Aiita/TP-Solarius/README.md

TP-Solarius - Lire explication projet pour plus d'information

Sommaire:
- Dossier à disposition: 
    - Programmes Solarius:
      - Programme de la mesure de puissance
      - Programme pour le fonctionnement du data logger
      - Mélange programme de mesure de la puissance et du fonctionnement du data logger
      - Programme lié au scénario 1
      - Programme lié au scénario 2

    - Documents Solarius
      - Flowchart scénario 1 et scénario 2 (format .png)
      - PV de livraison du produit
      
    - Vidéos/Photos 
      - Vidéo du fonctionnement du suivi de la lumière
      - Photo du montage fini du robot avec ses branchement
      - Vidéo du fonctionnement de la mesure de tension et de la puissance
      - Photo du fichier CSV après fonctionnement
