Aiita/TP-Solarius/Document_Solarius/Flowchart scénario 1.png

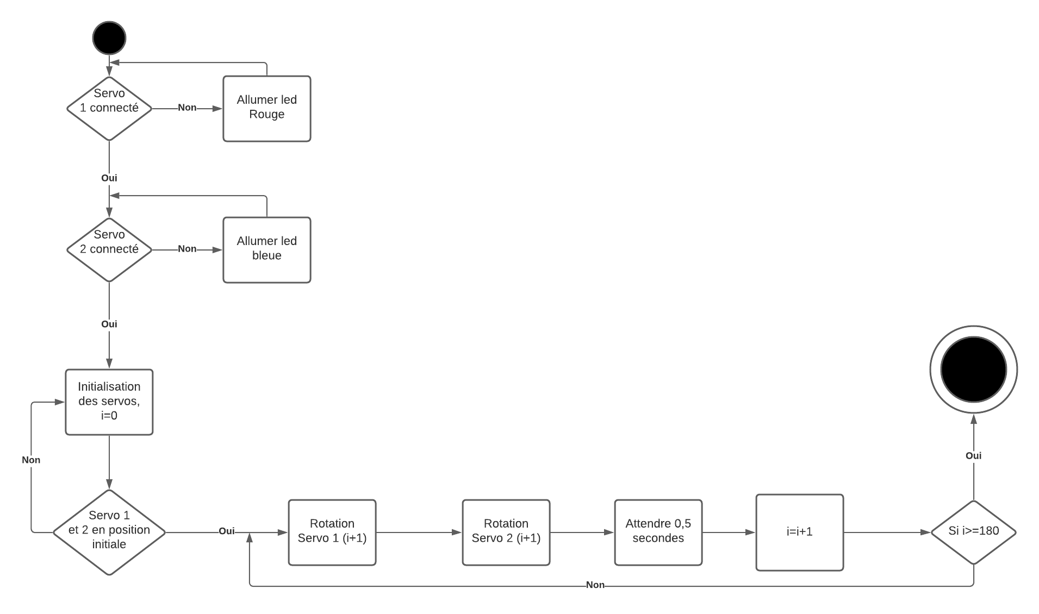
Document_Solarius/Flowchart scénario 1.png
