Aiita/TP-Solarius/Document_Solarius/Flowchart scénario 2.PNG

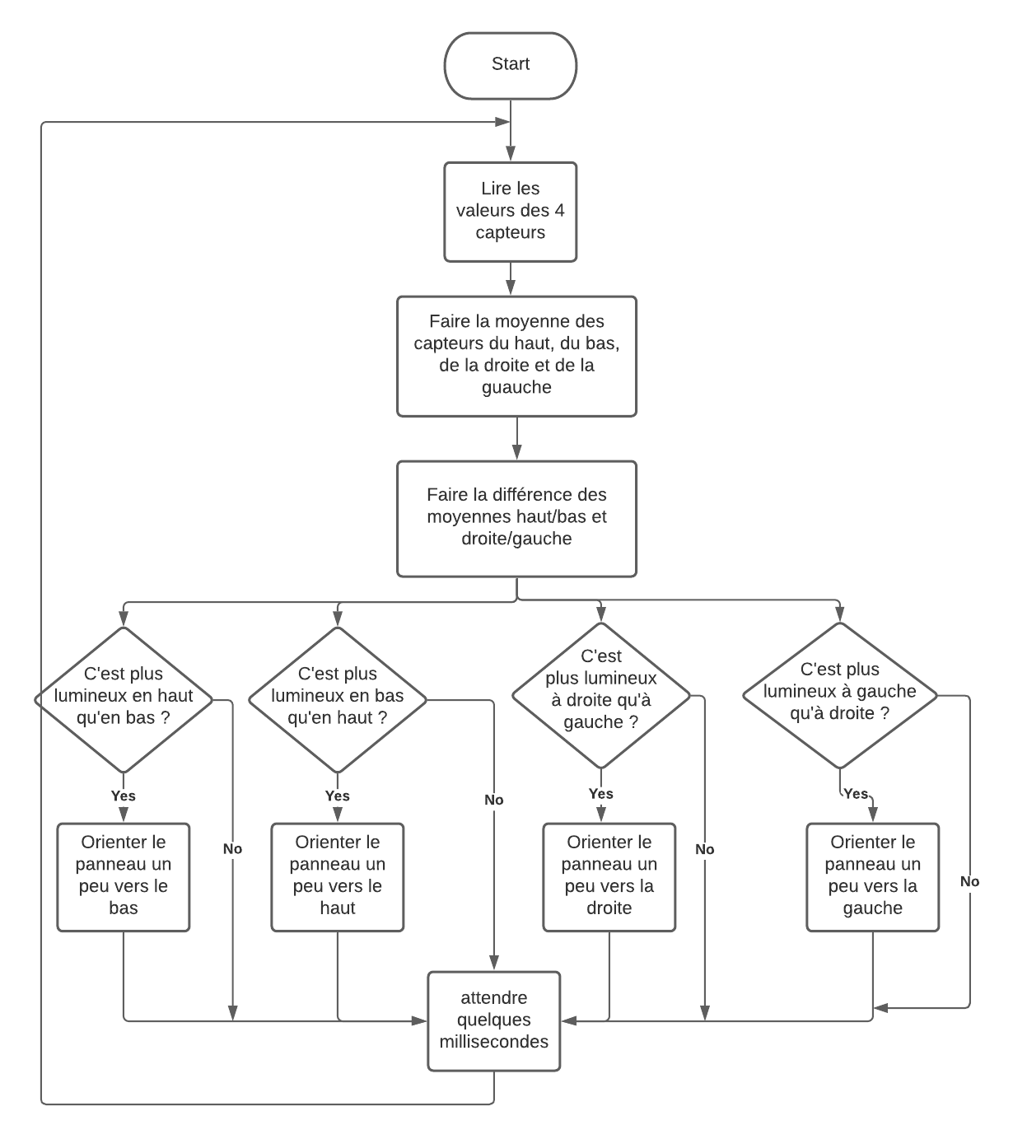
Document_Solarius/Flowchart scénario 2.PNG
