Aiita/TP-Solarius/Programmes_Solarius/Datalogger/Datalogger.ino

/*
Writing Sensor Data to an SD card
//
This example shows how to write data
to an SD card using the SD library.
//
The circuit:
* SD card attached to SPI bus as follows:
** MOSI - pin 11
** MISO - pin 12
** CLK - pin 13
** CS - pin 10 Uno (53 on Mega)af
Based on code by Tom Igoe
*/
//
#include "SD.h"
#include"SPI.h"
//
//the hardware CS pin (10 on most Arduino boards,
// 53 on the Mega) must be left as an output or the SD
// library functions will not work.
const int CSpin = 10;
String dataString =""; // holds the data to be written to the SD card
float power= 0.00; // value read from your first sensor
float voltage = 0.00; // value read from your second sensor

File sensorData;
//
//
void setup()
{
// Open serial communications
Serial.begin(9600);
Serial.print("Initializing SD card...");
pinMode(CSpin, OUTPUT);
//
// see if the card is present and can be initialized:
if (!SD.begin(CSpin)) {
Serial.println("Card failed, or not present");
// don't do anything more:
return;
}
Serial.println("card initialized.");
}
//
void loop(){
// build the data string
dataString = String(power) + "," + String(voltage) + "; // convert to CSV
saveData(); // save to SD card
delay(60000); // delay before next write to SD Card, adjust as required
}
//
void saveData(){
if(SD.exists("data.csv")){ // check the card is still there
// now append new data file
sensorData = SD.open("data.csv", FILE_WRITE);
if (sensorData){
sensorData.println(dataString);
sensorData.close(); // close the file
}
}
else{
Serial.println("Error writing to file !");
}
}
