Aiita/TP-Solarius/(commit log)

2021-06-01 Création du PV de Livraison - init
    Première création du PV.
2021-06-01 Première version programme arduino solarius - init
    Première version du programme arduino pour bouger les moteurs suivant la luminosité.
    Initialisation du programme
2021-06-01 Suite setup programme arduino
